d-e-v-o/LockManipulator-Locksport/Safe manipulation/Auto Dialer/AutoDialerTouch/Case/_BOTTOM.png

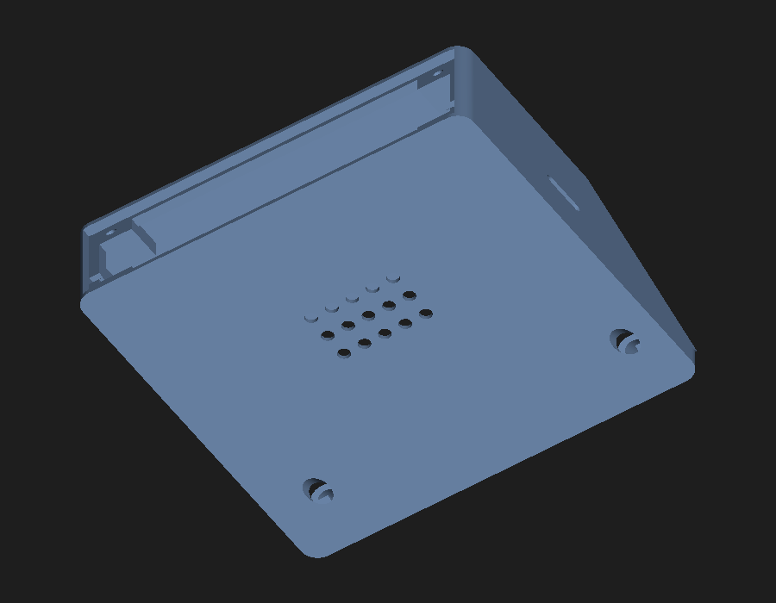
Safe manipulation/Auto Dialer/AutoDialerTouch/Case/_BOTTOM.png
