d-e-v-o/LockManipulator-Locksport/Safe manipulation/Auto Dialer/AutoDialerTouch/Case/_DESIGN_REVIEW.png

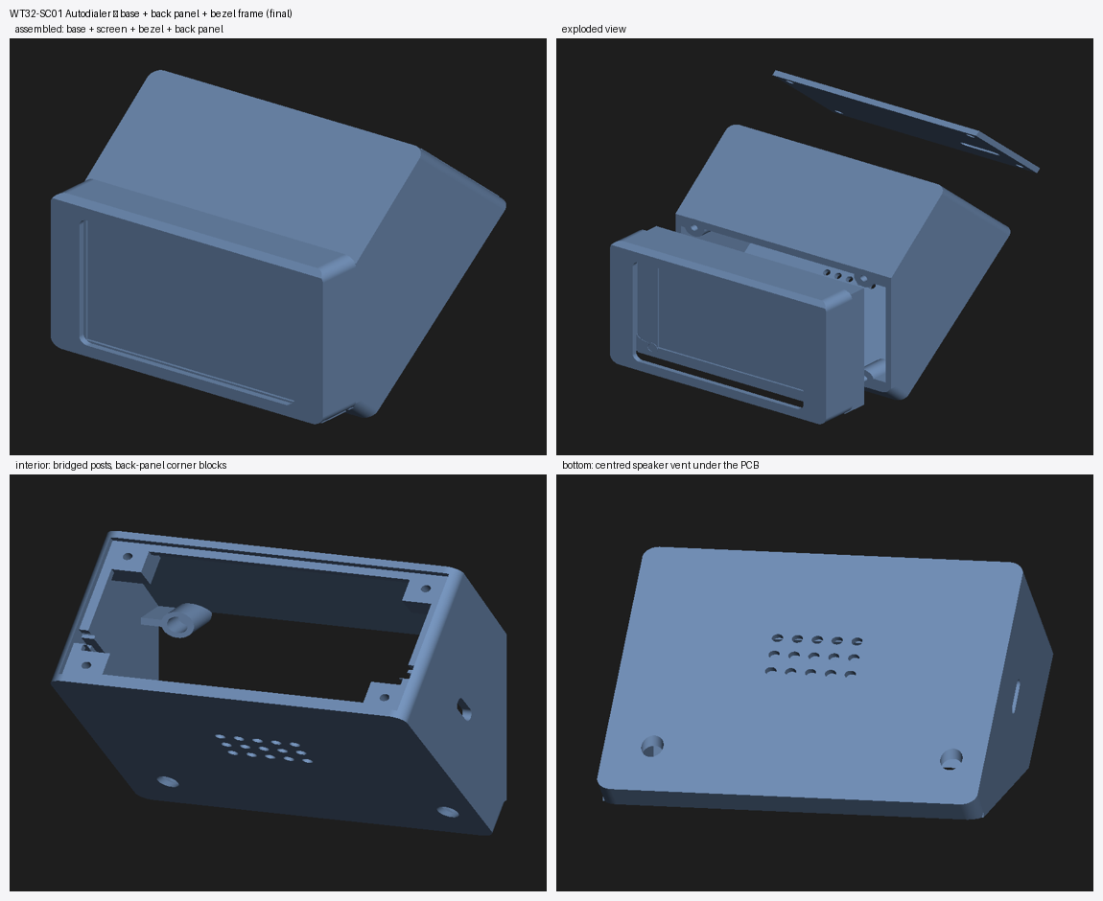
Safe manipulation/Auto Dialer/AutoDialerTouch/Case/_DESIGN_REVIEW.png
