d-e-v-o/LockManipulator-Locksport/Safe manipulation/Auto Dialer/AutoDialerTouch/Case/_INTERIOR.png

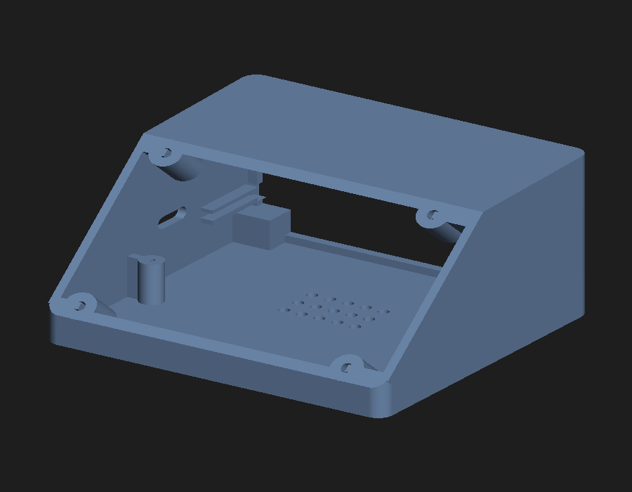
Safe manipulation/Auto Dialer/AutoDialerTouch/Case/_INTERIOR.png
