d-e-v-o/LockManipulator-Locksport/Safe manipulation/Auto Dialer/AutoDialerTouch/Case/PSU/PSU-Case-Grommet.step

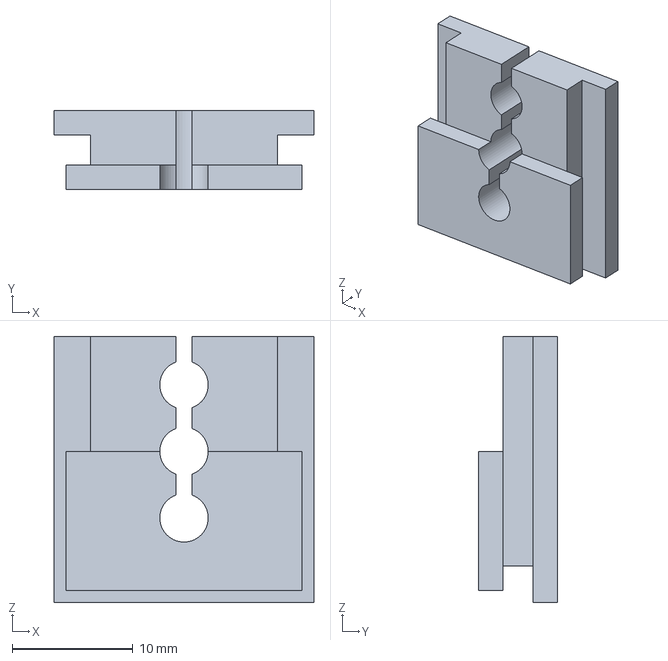
[picture p12: CAD file, 2026-07-27]
Safe manipulation/Auto Dialer/AutoDialerTouch/Case/PSU/PSU-Case-Grommet.step
21.5 x 6.50 x 22.0 mm
