d-e-v-o/LockManipulator-Locksport/Safe manipulation/Auto Dialer/AutoDialerTouch/Case/WT32-SC01-BackPanel-Autodialer.step

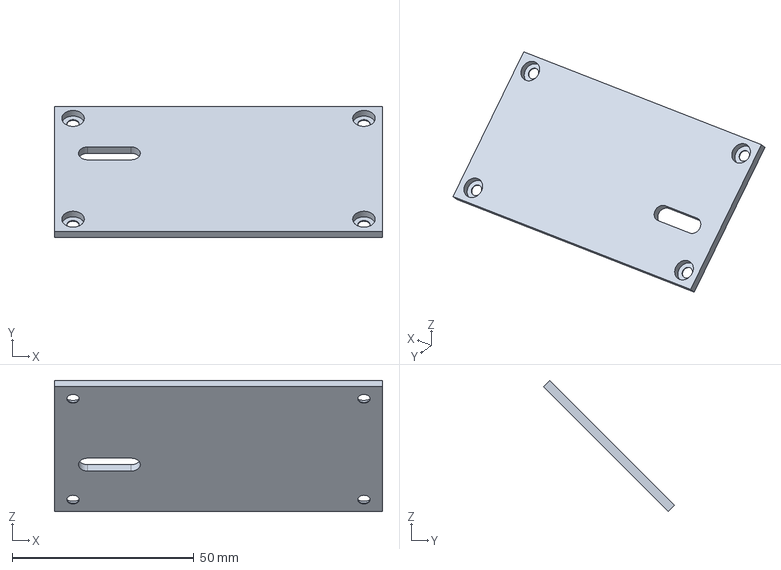
[picture p13: CAD file, 2026-07-20]
Safe manipulation/Auto Dialer/AutoDialerTouch/Case/WT32-SC01-BackPanel-Autodialer.step
90.2 x 36.1 x 36.1 mm
