d-e-v-o/LockManipulator-Locksport/Safe manipulation/Auto Dialer/Print files/stl/GripFeet.stl

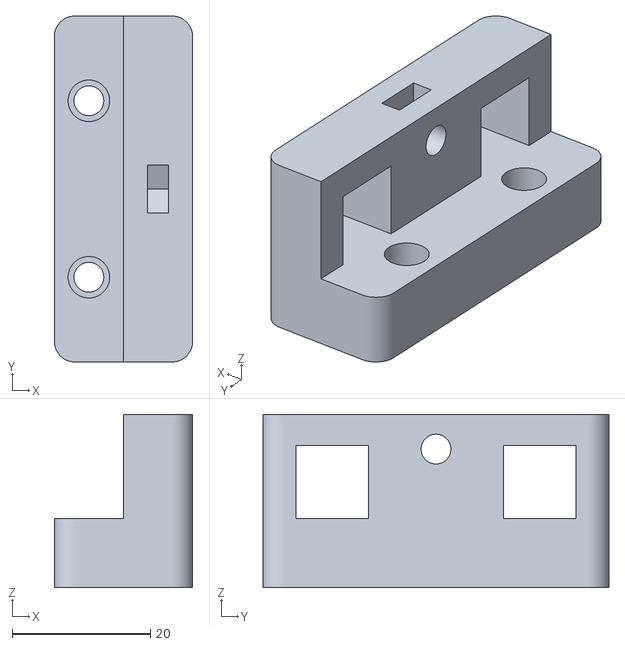
[picture p14: CAD file, 2026-10-29]
Safe manipulation/Auto Dialer/Print files/stl/GripFeet.stl
20.0 x 50.0 x 25.0
