d-e-v-o/LockManipulator-Locksport/Safe manipulation/Auto Dialer/AutoDialerTouch/Case/PSU/PSU-Case-Body.step

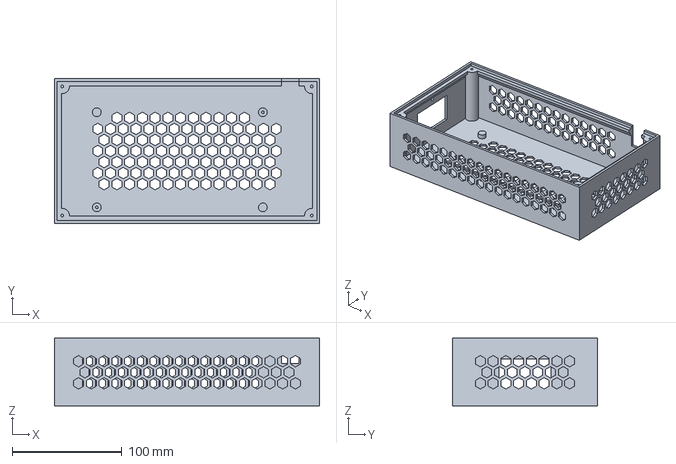
[picture p15: CAD file, 2026-07-22]
Safe manipulation/Auto Dialer/AutoDialerTouch/Case/PSU/PSU-Case-Body.step
241.0 x 131.5 x 61.5 mm
