d-e-v-o/LockManipulator-Locksport/Safe manipulation/Auto Dialer/AutoDialerTouch/Case/WT32-SC01-Base-Autodialer.step

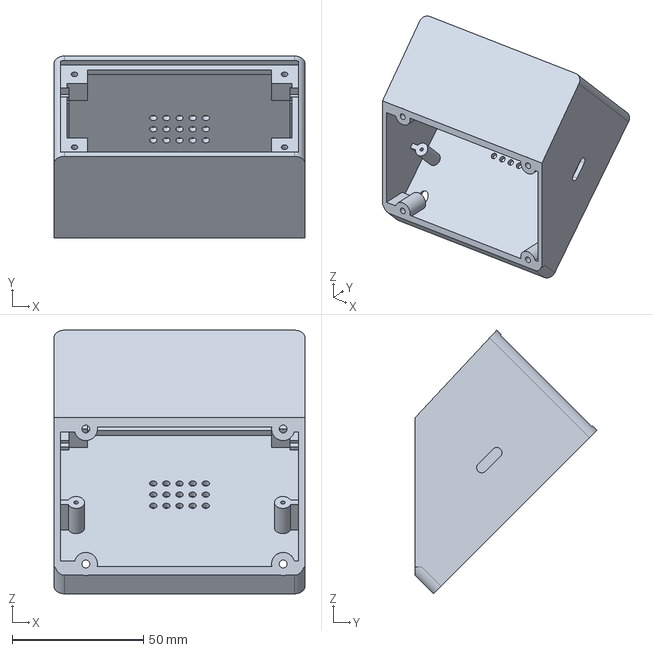
[picture p16: CAD file, 2026-07-20]
Safe manipulation/Auto Dialer/AutoDialerTouch/Case/WT32-SC01-Base-Autodialer.step
95.6 x 69.3 x 100.4 mm
