d-e-v-o/LockManipulator-Locksport/Safe manipulation/Auto Dialer/AutoDialerTouch/Case/PSU/PSU-Case-Lid.step

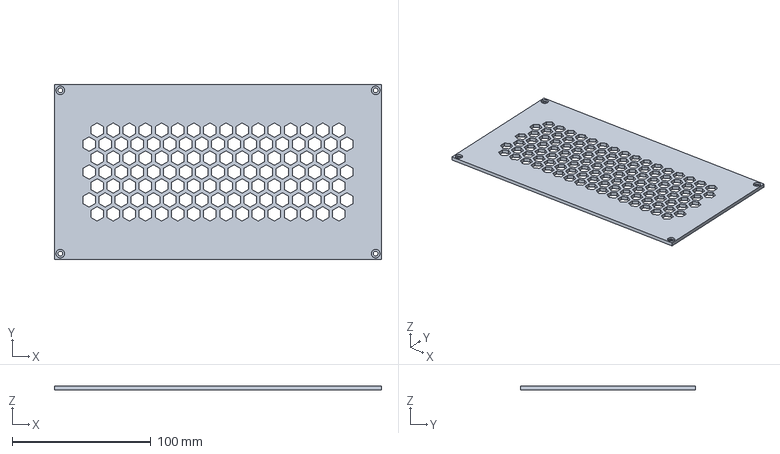
[picture p17: CAD file, 2026-07-22]
Safe manipulation/Auto Dialer/AutoDialerTouch/Case/PSU/PSU-Case-Lid.step
235.4 x 125.9 x 3.00 mm
