d-e-v-o/LockManipulator-Locksport/Safe manipulation/Auto Dialer/AutoDialerTouch/Case/WT32-SC01-Frame-Autodialer.step

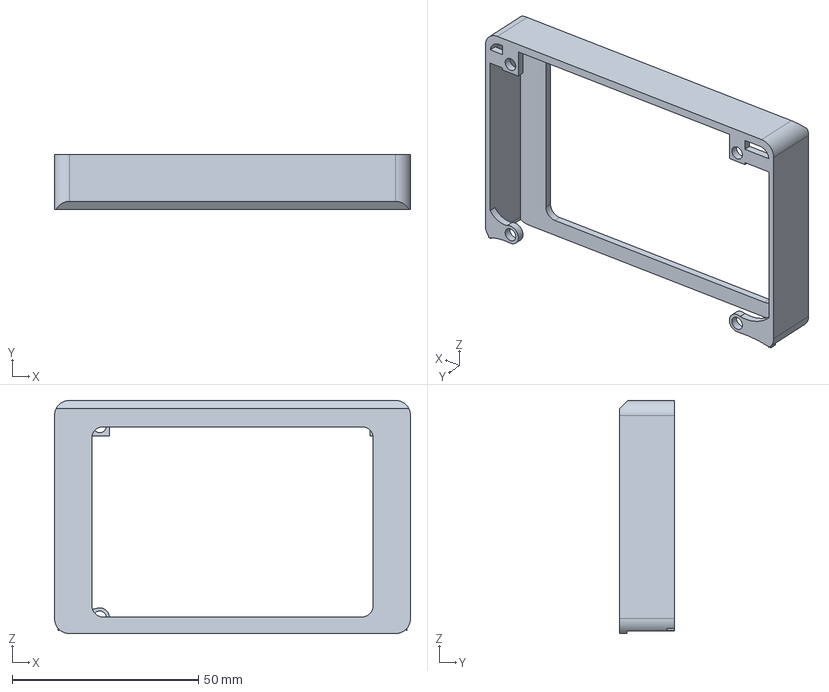
[picture p18: CAD file, 2026-07-20]
Safe manipulation/Auto Dialer/AutoDialerTouch/Case/WT32-SC01-Frame-Autodialer.step
95.6 x 14.8 x 62.6 mm
