d-e-v-o/LockManipulator-Locksport/(list of files, cad)

Other CAD files:
Safe manipulation/Auto Dialer/AutoDialerTouch/Case/WT32-SC01-BackPanel-OpenSlot-Autodialer.step
Safe manipulation/Auto Dialer/AutoDialerTouch/Case/PSU/PSU-Case-Body.stl
Safe manipulation/Auto Dialer/AutoDialerTouch/Case/PSU/PSU-Case-Grommet.stl
Safe manipulation/Auto Dialer/AutoDialerTouch/Case/PSU/PSU-Case-Lid.stl
Safe manipulation/Auto Dialer/AutoDialerTouch/Case/WT32-SC01-BackPanel-Autodialer.stl
Safe manipulation/Auto Dialer/AutoDialerTouch/Case/WT32-SC01-BackPanel-OpenSlot-Autodialer.stl
Safe manipulation/Auto Dialer/AutoDialerTouch/Case/WT32-SC01-Base-Autodialer.stl
Safe manipulation/Auto Dialer/AutoDialerTouch/Case/WT32-SC01-Frame-Autodialer.stl
