d-e-v-o/LockManipulator-Locksport/Safe manipulation/ITL-2000 manual.pdf

# ITL-2000 Manual

# Interface

Screen: Top line is output, bottom line is user input. The main menu will read ready.
Set Speed: Changes speed.
Set Drop: Set starting point (drop), contact area width (offset), checkpoint, and dialing increment Setup: Test dialing accuracy/configure individual wheel settings.
Left/Right: Change for left or right handed locks.
Dial: Starting dialing.
Combo: View last attempted combination.
Clear: Backspace. Clears input text if available or exits menu if no input text is displayed. Holding this button while the machine is dialing will stop the machine.
Reset: Hold to reset all settings.

Each button is a menu besides clear and reset. When in that button’s menu, that button will behave as an enter key. If you enter an input on the number pad, you will press that button to confirm the input. If there is no input then it will progress to the next screen of that menu or if there are no more screens in that menu then it will simply return to the main screen.

# Finding the contact points/contact area

1. Spin the dial right 4 times and stop on 50.
2. Slowly turn left until you feel a “bump”. This will be very slight and can be hard to feel. Practice with a lock that has the back cover off. You are attempting to feel for when the nose drops into/comes out of the cutout on the drive cam (the cutout being the contact area). When point at which the nose makes contact with the drive cam on either side are the two contact points. From the perspective of looking at the dial the right most contact point (according to the numbers on the dial) is the right contact point and the left most is the left contact point. From looking at the drive cam the right contact point is usually more inclined unless you are practicing with a diebold. The contact points will feel more solid if you are approaching it from inside the contact area so you may not notice when the nose drops into the contact area at first but you should be able to notice when it makes contact with the right contact point. You will need to find both contact points.
3. Locate the center of the contact points and that is the center of the contact area. Round down to the nearest whole number and that is what you will use for the center of the contact area.

# Setting up the dialer

1. Locate the center of the contact area.
2. Place spacers on the front of the lock so the magnets are able to be pulled off and so the front of the safe won’t be damaged (2 towels with a hole to fit over the dial is recommended).

3. Place dialer on the front of the safe door, centered over the dial. Add washers to motor posts if needed.
4. Ensure you are on the main menu (the screen will read ready if you are on the main menu) and press setup and the dial will do a calibration spin.
5. Spin the dial to the center of the contact area (the number you found in step 1).
6. Tighten the collar around the dial keeping the dial in the center of the contact area. If the motor spins during this, you will need to loosen the collar and start again from step 4. You must make sure the dial is gripped very tightly!
7. Press setup and check that the dial has returned to the same position. If not, loosen the collar and start again from step 4.
8. Press clear to exit the setup menu.

# Configuring necessary parameters

1. From the main menu press set drop.
2. Enter the number the dial is currently at (the center of the contact area).
3. Press set drop again to confirm.
4. Press set drop to move to setting the offset. The offset is the size of the contact area divided by 2. This should always stay at 4 as that is the size of most contact areas (4 above and 4 below the center of the contact area). This machine will not attempt any numbers in this range for the third number of the combination hence keeping it at 4; any higher and it might not even try the correct combination for the third number. If the screen does not state that the offset is 4, press 4 then set drop again to confirm.
5. Press set drop again to move onto setting the checkpoint. The checkpoint is how far the machine will spin the dial past the contact area to check if the lock is open. This should always be at the max of 26 as any lower and it will not spin far enough to detect an open lock; it will simply relock the lock. If the screen does not display 26, enter in 26 and press set drop to confirm.
6. Press set drop again to enter the dialing increment. This is how many numbers it will dial by, i.e. if this is 2 then it will advance each number in the combination by 2. This should always be at 2 as any higher and the combination may not be found. Any lower and you are simply sacrificing time for no gain.

# Set custom dialing ranges for each wheel

1. From the main menu press the wheel you would like to edit and then press setup.
2. Enter 1 to change the dialing mode for that wheel to custom range (screen should read fixed increment). If you are wanting to change the dialing range for the wheel to include all numbers then enter in 2. Press setup again to confirm and the screen should read auto increment. If you have entered 2, then press setup again to return back to the main menu otherwise move onto step 3.
3. Press setup to move onto setting the range for that wheel. On this screen, the first number for the range will be the lowest/left most number you want to start and the second number for the range will be the highest/right most number you want to attempt if you are editing wheels 1 or 3. If you are editing wheel 2 then this will be switched. The first number will be the highest/right most number you want to start at and the second number will be the lowest/left most number you want to attempt. If you mix up the two cases then that has the effect of EXCLUDING your desired range. I suggest keeping all numbers odd if the center of the contact area is odd and even if the center of the contact area is even, although it will work even if this is not the case. It simply might omit the last number in the range if you do not take this advice.
4. Enter your starting range value as per the instructions in step 3 and press setup to confirm.
5. Press setup to move onto setting the stop value for the range.
6. Enter your stop value for the range as per the instructions in step 3 and press setup again to confirm.
7. Press setup to exit the setup menu.
8. Repeat for as many wheels as necessary.

# Starting the dialing sequence

1. Ensure you have followed all instructions to set up the dialer and configure necessary parameters. Make extra sure you have correctly identified the center of the contact area or else the machine will not recognize when the lock is open as it will not be able to even test if the lock will open with the most recently dialed combination.
2. Follow all steps to set custom dialing ranges for each wheel if you wish to set up custom ranges for each wheel, i.e. if you know the second number in the combination is between 30 and 50 for instance. Otherwise, follow the same steps up to step 2 for each wheel to ensure that the dialer will attempt every possible combination.
3. Press dial and it should start. Make sure the collar gripping the dial is not slipping. If it is, repeat all steps.
4. If the dialer has found the combination, you should be able to simply turn the dial to the right (clockwise) and it will stop moving and you can open the safe. DO NOT re-lock the safe until you have confirmed the correct combination!
5. If the dialer has found the combination and the dial does not stop moving within 1 rotation when turning the dial to the right then you will have to dial in test combinations based on what the dialer says is the correct combination.
- In this instance we will pretend the dialer states 20,40,60 is the correct combination. W1 will stand for the first number in the found combination, w2 for the second, and w3 for the third.
- Manually dial the following patterns and check if the lock opens after each line.

w1 minus 2, w2 minus 2, w3 minus 4
w1 minus 2, w2 minus 2, w3 minus 2
w1 minus 2, w2 minus 2, w3 plus 2
w1 minus 2, w2 minus 2, w3 plus 4

w1 minus 2, w2, w3 minus 4
w1 minus 2, w2, w3 minus 2
w1 minus 2, w2, w3 plus 2
w1 minus 2, w2, w3 plus 4

(cont.)

w1 minus 2, w2 plus 2, w3 minus 4 w1 minus 2, w2 plus 2, w3 minus 2
w1 minus 2, w2 plus 2, w3 plus 2
w1 minus 2, w2 plus 2, w3 plus 4

Hopefully you can see the pattern here. We will repeat this all again a second time but with the first number being the found number. Then repeat it a third time but with w1 plus 2 as the first number.

# Warning and troubleshooting

- Do NOT fully loosen the collar that grips the dial. The teeth do not work well and will grip the dial off center. If this occurs and you must re insert the teeth into the collar, follow the below steps:
1. Each tooth is numbered and each slot on the collar is numbered. With the teeth out, turn the collar as if you are loosening the tightness and you should see a spiral where the teeth meet the collar. Turn until you see the start of the spiral and set it to be just slightly past where the slot for the first tooth is.
2. Insert each tooth in the appropriate slot.
3. Firmly press in on all teeth and slowly tighten the collar. Make sure all teeth are getting drawn in at roughly the same rate and distance. Continue until the teeth are roughly halfway in and if they are not drawn in roughly the same amount then restart.
- In the set drop menu, the offset should always read +-4.
- In the set drop menu, the checkpoint should always read 26.
- If a custom dialing range for each wheel has been set, ensure that for wheels 1 and 3 the first number is the lowest/left most number you want for that range. For wheel 2, ensure the first number is the highest/right most number you want for that range. The second number for the range is the stop number. For wheels 1 and 3, ensure that it is the highest/right most number for that range. For wheel 2, ensure the it is the lowest/left most number for that range.
- If the dialer has completed it’s dialing sequence and the lock is still locked then either it is broken and inoperable and must be drilled or read through this section and ensure you have everything set up correctly.
- Do not attempt to use this on a 4 wheel lock. You can theoretically setup a “wheel 0” but this is purposefully omitted. In a worse case scenario it takes 55.5hrs to dial all combinations on a 3 wheel lock with an average opening (on truly random combinations) at half that. With a 4 wheel lock, it will take 2,775 hours to dial every combination. With an average opening of 1,387 hours. This is 58 days on average!
- Other information not included is changing the speed as I believe this should not be touched. It spins at a speed that I consider to be the edge of what it should be spinning at. Changes of failure while dialing will be quite high if set to a higher speed. The manual does state that for stiffer dials the speed can be turned down, although in my experience of manually changing the dial stiffness it will still work on the current speed. If the dial is so tight that the motor does not want to spin, simply lowering the speed might allow it to spin but will burn out the motor so I don't recommend this unless it's the last time you plan on using the machine.
- The left/right menu button to my knowledge is obsolete as this will attempt to open a lock with a final left turn instead of right. I am not aware of any locks like this that is compatible with this machine.
