d-e-v-o/LockManipulator-Locksport/Safe manipulation/Auto Dialer/Auto Dialer Manual.pdf

# Auto Dialer Manual

Wifi Name: AutoDialer | Wifi Password: AutoDialer
Home Page: 192.168.0.1 | Home Page Username: root | Home Page Password: toor

### Disclaimer

1. This device is not intended for any illegal purposes. Only use this on safes you own or have explicit permission to use it on.
2. This device is not guaranteed to work.
3. Motor will be hot after running. Do not touch, it will burn!
4. This is (usually) a destructive opening device. It is likely that some internals of the lock will be destroyed due to mechanical wear and need to be replaced. Speed does not change this. This is caused by the sheer amount of combinations being entered and will age the lock by decades. If the lock is an antique or rare lock, please consider manipulation first. If an auto dialer can open a lock, then manipulation can too.

### Lock compatibility

This device does not work on locks that require an additional action to open, such as pushing in the dial (S&G 8500/2900 series locks and Star/AMSEC push in dial safes) or direct entry locks. If your dial can be pushed in like a button at any point then this device will not work. If you apply pressure to the handle (try both directions) and the dial gets much harder/impossible to turn, this device will not work.

### Setting up the Auto Dialer

1. Put a rag/towel over the magnet on the leg and slide it onto the front of the safe near the dial.
2. Slide metal rods through the leg slide and tighten the screws.
3. Slide the leg slide onto the leg.
4. Slide the motor onto the rods.
5. While holding the motor centered on the dial, tighten the grippers onto the dial with a flat head screwdriver.
6. Tighten the screws on the motor and leg to hold everything in place.
7. Slowly spin the dial, making sure the motor has minimal to no wobble. If there seems to be excessive wobble or force on the motor, remount it.

DO NOT TOUCH DEVICE WHILE OPERATING! It can, and will, cause serious injury. Ask me how I know.

No device is perfect. It is recommended to be within earshot of the device in case of a false negative when checking if the lock is open. When the lock opens, you will hear a *clunk* as it unlocks. If the device falsely determines the lock is not open, it will sound like *clunk clunk* as it unlocks and relocks the lock. If you hear this, stop the device immediately by either the "Emergency Stop" button or turning it off. Try the most recent combinations or restart the device and limit the search area.

### Terminology

Left rotation: This is spinning the dial counterclockwise. Or, if you imagine it's a wheel of car while looking at the side of the car, it's spinning in a way to move the car to the left.

Right rotation: This is spinning the dial clockwise. Or, if you imagine it's a wheel of a car while looking at the side of the car, it's spinning in a way to move the car to the right.

Drop-in area: The area on the dial where the internals of the lock check for a correct combination. It is defined as being the space between the left and right contact points. Also known as a contact area.

Contact point: This is a point of resistance that is always on the dial in the same place. Do not mistake feeling the wheels in the lock for the contact point. The wheels will pick up where you leave them so the resistance will change places, unlike a contact point. There are usually 2 of these roughly ~5-15 numbers apart. These points are best felt from within the drop-in area.

Left contact point: This is the point felt when spinning right, thus visually it is to the left of the right contact point on the dial.

Right contact point: This is the point felt when spinning left, thus visually it is to the right of the left contact point on the dial.

### Locating the contact points

1. Spin the dial 1 rotation to the left. It does not matter where the dial currently is, just spin 1 rotation left.
2. Continue spinning left until you reach 50 and stop on 50.
3. Slowly turn right until you feel some resistance trying to stop the dial from moving. This should occur before you get back to 50. If you get back to 50 without feeling it, start the process over.
4. The resistance will be best felt turning right. Going back and forth over it should result in it staying on the same number.
5. This is the left contact point. From here, slowly turn left to locate the right contact point. It should be within ~7-15 numbers of the left contact point.

### Determining the number of wheels

1. Spin the dial at least 5 times in either direction and stop on 50.
2. Reverse the direction and feel for resistance each time you pass 50. As you pass 50, make sure you turn slow, gentle, and continuous. The resistance is not always easy to feel. And you must be continuous in your turning, otherwise you will feel the resistance of wheels you've already picked up.
3. Each time you feel resistance while passing 50, add 1 to the number of wheels.
4. It is likely that the resistance will not be felt at exactly 50. It will tend to drift past 50, usually by 0.5 increments each time. So for a 3 wheel lock, you will feel the first resistance 0.5 increments past 50, then the second resistance 1 increment past 50, then the last resistance 1.5 increments past 50.

### Using the controls

Current number: Enter the current number on the dial (using decimals if it's not a whole number) and click "Center" to automatically center the dial on 0.

Spin dial: Spins the dial left and right to make sure it returns to 0 properly.

----------------------------------------------------------------------------------------------------------------------------Wheel setup

Wheels are added in order of 1, 2, 3, etc with wheel 1 being the wheel furthest from the drive cam (and 1st number in the combination). If you remove a wheel and your wheels are not numbered consecutively anymore, the next wheel added will be the first missing wheel (e.g. You have wheels 1, 2, and 3 and remove wheel 2 to be left with wheels 1 and 3. The next wheel you add will slot in as wheel 2.).

Open rotation: The direction the wheel spins when entering the combination. Be aware that wheels will increment either up or down depending on their open rotation. If a wheel opens with a left rotation, it will increment it up. And if a wheel opens with a right rotation, it will increment it down.

Exclusions: Enter numbers or a range going up (i.e. 10-30) that are not to be tested, start and end inclusive, and comma separated (e.g. 5, 17.5, 50-60, 75). If you know the correct number, add a range around it i.e. 21-19 if 20 is the correct number (NOT 19-21 as that excludes the correct number!). Keep in mind your "Test every 'x' numbers" value since if it's even such as "2", then a range around an odd number (e.g. 22-20) will result in no valid possible combinations. If you know a number and it's odd, it's best to allow the number below and above (e.g. 23-19 if 21 is the number). ----------------------------------------------------------------------------------------------------------------------------

Possible known numbers: Possible numbers which might be in the combination. Tries all permutations of these before brute forcing. Enter comma separated numbers. You must enter at least as many numbers as in the combination.

Speed: Higher is faster, defaults to 3. The main differences between speeds is the acceleration/deceleration. The top speed only slightly changes as top speed does not make as much difference as the deceleration. If the wheels in a lock spin too freely, then they can carry momentum and keep moving after the dial stops, which is solved by a longer deceleration time. Higher speed is also less torque so reduce speed if the dial is harder to turn. Recommended speed is 2 or 3.

Speed 1: ~55 combinations/min
Speed 2: ~65 combinations/min
Speed 3: ~80 combinations/min

Left contact point: Enter the left contact point for the lock, can have a decimal point but nearest whole number works fine. The left contact point is the one felt while turning the dial to the right.

Right contact point: Enter the right contact point for the lock, can have a decimal point but nearest whole number works fine. The right contact point is the one felt while turning the dial to the left.

Test every "x" numbers: How many numbers to count by when testing combinations. Can have a decimal point. Rarely will this need to be changed.

Start wheel 1 at: Which number to start with for the first number in the combination. For instance, not many people choose 0 as the first number in the combination. Can have a decimal point but keep in mind your "Test every 'x' numbers" value as it will increment by that amount from here.
Lock opening rotation: What direction the dial turns to open the lock after dialing the combination. Will be "Right" for most modern 3 wheel locks.

Test drop-in area: Whether to check for the last number in the combination within the drop in area. Can safely be "No" in most cases as the last number being in this range is an invalid combination.

Distance to open: How far past a contact point to check for the lock being open. For instance, if the lock opens with a right rotation, it will spin "x" numbers to the right past the left contact point to check for the dial stopping. This must be far enough for the dial to stop moving in order for the device to detect it is open. Recommended value is 20.

Avoid numbers within "x": Don't try combinations where consecutive numbers are within "x" of each other. Recommended values are 3-5.

Rotational conversion: The difference in location a wheel will pick up from where it's left when going in the opposite direction. Can be ignored unless you have a very specific need. If you don't know what this is, you don't need it. A common value in modern safe locks is 0.5.

### After device stops

DO NOT TOUCH MOTOR! It will be very hot!

If the device has stopped, turn it off and try opening the safe. If the safe opens, do NOT re-lock it until you have properly recovered the combination from the lock itself! Do NOT trust the combination that the device says it opened on. Wheels can carry momentum so the dialed combination may not be the actual combination. The dialed combination may also be close to, but not quite on, the actual combination and dialing by hand will not result in the lock opening again.

In the case of the device going through all possible combinations (not open):
1. The last number is in the drop-in area and the device was told to not try this.
2. Consecutive numbers are closer than what the device was told to check.
3. The speed might've been too fast and the wheels are carrying momentum and not stopping.
4. If the speed is too high, and the dial harder to turn, the motor can be skipping steps.
5. The device did open the lock but had a false negative when checking.
6. The gripper could be slipping on the dial if not tight enough.

In the case of the the device says the lock is open but it's not: The device most likely had a false positive when checking if the lock is open. You can restart it but start from roughly where it left off. Look at what numbers have been tried for the first number in the combination and exclude that zone from the first wheel. Do not do this for the other wheels.
