d-e-v-o/LockManipulator-Locksport/(commit log)

2026-06-08 WT32-SC01 Plus Port or AutoDialer
    Adding a (Claude-assisted) port of the AutoDialer code for the WT32-SC01 Plus board, including a touchscreen UI. Untested, as I am still waiting for parts for my build.
2026-07-13 WT32-SC01 Plus: audio, on-screen diagnostics, live UI, upstream reconnect fix
    Onboard UI/audio for the WT32-SC01 Plus port:
    - I2S audio: button-click feedback, 3-note chime on detected open, and an
    on-screen volume control (0/25/50/75/100 -> tuned amplitude scalars).
    - Touch input on a dedicated core-0 task so Emergency Stop / Pause stay
    responsive during a run; stop/pause mirrored to the web SSE from core 1.
    - Large red "STOPPED!" banner on emergency stop.
    - On-screen TMC5160 diagnostic panel (SPI, charge-pump, faults, cs_actual,
    STEP/DIR mode + wiring readback) so the driver can be debugged with no
    serial cable. GSTAT cleared + settled before sampling to avoid a false
    power-on ch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
    [AutoDialerTouch.ino, Display.h]
2026-07-20 Add WT32-SC01 Plus touchscreen case (Auto Dialer)
    3D-printable desk enclosure for the touchscreen Auto Dialer build: base,
    front bezel, and two removable back-panel variants (closed / open cable
    slot), plus parametric build123d generators, render images, and README.
    Houses the WT32-SC01 Plus, an ElectroCookie perfboard with TMC5160 +
    heatsinks, a 5V->3.3V regulator, and speaker. Inspired by Printables
    model 322687.
    [WT32-SC01-BackPanel-Autodialer.step, WT32-SC01-BackPanel-Autodialer.stl, WT32-SC01-BackPanel-OpenSlot-Autodialer.step, WT32-SC01-BackPanel-OpenSlot-Autodialer.stl, WT32-SC01-Base-Autodialer.step, WT32-SC01-Base-Autodialer.stl, WT32-SC01-Frame-Autodialer.step, WT32-SC01-Frame-Autodialer.stl]
2026-07-22 Add PSU enclosure for the Auto Dialer
    Vented case for the mains PSU + screw-mount IEC inlet, with a removable
    honeycomb-vented lid. PSU screws to corner standoffs; terminal block faces a
    1.5" access bay for spade connectors; low-voltage harness exits to the lid.
    Parametric build123d generator plus STL/STEP for body and lid.
    [PSU-Case-Body.step, PSU-Case-Body.stl, PSU-Case-Lid.step, PSU-Case-Lid.stl]
2026-07-22 Add PSU case render images + reference them in the README
    Fresh renders of the final geometry (exploded body+lid, interior, inlet end).
2026-07-22 PSU case README: print/bed-fit notes and flag-terminal plan
    Record what was learned from the first successful print:
    - Bambu X1 support threshold of 10 deg supports only the inlet cutout
    - 241mm body footprint defeats auto-arrange on the 256mm bed; place manually
    - body and lid must be printed separately
    - +X bay clearance is resolved with right-angle flag spade terminals
2026-07-27 Add PSU case TPU cable grommet + README notes
    Slip-in strain-relief grommet for the 3x 14 AWG harness at the cable notch:
    groove grips the wall, lid traps the top, 3x Ø4 holes with a top slit for
    side-loading. Handed (full-height outer flange out; inner flange relieved to
    clear the lid ledge, 2 mm overhang for easier insertion). Print in TPU at <=20%.
    README also captures the measured terminal sizes (#8 PSU studs, .187 flags on
    the 5 mm inlet tabs), the Bambu 10-degree support setting, and the X1 bed-fit /
    manual-placement workaround.
    [PSU-Case-Grommet.step, PSU-Case-Grommet.stl]
2026-07-31 PSU README: mark grommet Ø4 holes and both terminal sizes as verified
